mimeiners/hil/files/mom/Meeting_Minutes_06.07.md

# Protokoll vom 06.07.2023

## Abgabe Projekt Gimbal 17.08.2023
### Abgegeben wird:
- Repository vollständig.
- Testkonzepte.
- funktionierender Gimbal
