mimeiners/hil/files/mom/Meeting_Minutes_14_06.md

# Testkonzept stand 14.06

* Sensor-Genauigkeitstest
* Reaktionsgeschwindigkeitstest
* Stabilitätstest
  
## Aufgabe bis zum 15.06
Gedanken für ein Testkonzept machen (Magic System reinschauen) und dann in der Gruppe besprechen
(Nur für Hardware!)

## Aufgabe zum 15.06
 1. Start mit der besprechnung vom Testkonzept.
 2. Zusammenbaum vom Gimbal erster aufbau und ggf. neuen 3D Druck starten
