mimeiners/hil/files/mom/Meeting_Minutes_25_05.md

# Protokoll vom 25.05
Aufgaben bis zum 01.06.
## Team Elektronik

### Aufgaben
**Motoren Ansteuern mit dem ESP und dem Arduino**

---

## Team 3D

### Aufgaben
**Bis nächste Woche soll SE Demonstrator_1.0 auf das nötigste gekürzt werden.**
