mimeiners/hil/files/mom/Meeting_Minutes_11_05.md

# Protokoll vom 11.05

Das Team hat beschlossen, sich in zwei Gruppen aufzuteilen, um mögliche Fernsteuerungen in das Projekt einzubinden. Es werden zwei Microcontroller verwendet: Arduino Nano und ESP.

## Elektronik TEAM ARDUINO
- Xingpeng Chen
- Qian Liu

## Elektronik TEAM ESP
- Xie Yang
- Bola Poules

---

## 3D TEAM ARDUINO
- Atakan Baydogan
- Yolande Maeva Pokam Fotue (50% Beteiligung)

## 3D TEAM ESP
- Yasincan Kahraman
- Yolande Maeva Pokam Fotue (50% Beteiligung)

Kommentar: Bis die Microcontroller programmiert sind, wird das 3D-Druck-Team die Grundidee bzw. die Theorie für "Hardware in the Loop" entwickeln.
