mimeiners/hil/class/01_lec.md

# Einleitung und Übersicht

"Das modellbasierte System-Engineering (MBSE) ist eine formalisierte Methodik, die zur Unterstützung der Anforderungen,
des Entwurfs, der Analyse, der Verifizierung und der Validierung im Zusammenhang mit der Entwicklung komplexer Systeme
eingesetzt wird. Im Gegensatz zum dokumentenzentrierten Engineering stellt MBSE die Modelle in den Mittelpunkt des
Systementwurfs. Die zunehmende Verbreitung digitaler Modellierungsumgebungen in den letzten Jahren hat zu einer
verstärkten Anwendung von MBSE geführt. Im Januar 2020 stellte die NASA diesen Trend fest, indem sie berichtete, dass
MBSE sowohl von der Industrie als auch von der Regierung zunehmend als Mittel zur Beherrschung der Systemkomplexität
angenommen wird. In diesem Blogbeitrag gebe ich eine kurze Einführung in MBSE." [@shevchenko2020]

Übersetzt mit www.DeepL.com/Translator (kostenlose Version)

## Lernziele des Moduls

* Systems Engineering (SE)

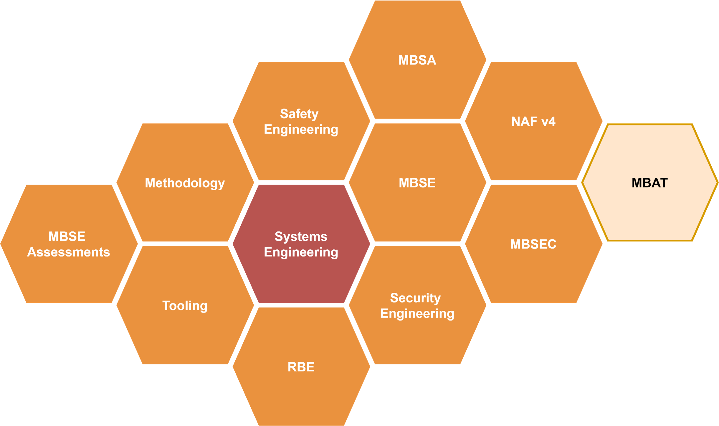
[picture p17: images/Overview_SE.png]
Übersicht Systems Engineering


* Requirements Based Engineering (RE)

	* Grundlegende Prinzipien

	* Stakeholder Requirements

	* System Requirements

	* Requirements Compliance

	* Requirements schreiben

	* Verlinken & attributieren von Requirements

	* Verifikation & Validierung von Requirements

::: {.callout-note}
Verifizierung oder Verifikation (von lateinisch veritas ‚Wahrheit‘ und facere ‚machen‘) ist der Nachweis, dass ein
vermuteter oder behaupteter Sachverhalt wahr ist. [@dewiki:246302640]
:::

::: {.callout-note}
Validierung oder Validation (von lateinisch validus "kräftig, wirksam, fest")[@dewiki:249118232]

* Validierung (Chipentwurf), Vergleich des Chipdesigns mit der vorgegebenen Spezifikation.

* Validierung (Informatik), Nachweisführung, dass ein System die Praxisanforderungen erfüllt.
:::

* Model-Based Systems Engineering (MBSE)

	* SysML als Basis für MBSE

	* Diagramme der SysML

	

	* Alternative MBSE-Sprachen

	* Tooling

* Methodiken und Prozesse

	* MBSE Assessment

	* MBSE Prozess

	* MBSA - Model Based Safety Analysis

	* MBAT - Model Based Analysis and Testing

	* MBSec - Model Based Security

## Wissenschaftliches Rechnen / Modellierung

* [CATIA | No Magic](https://docs.nomagic.com/display/MSI2024xR1/User+Guide)

* [Matlab (Campus Lizenz)](https://de.mathworks.com/academia/tah-portal/hochschule-bremen-31463273.html)

* [Python (Anaconda)](https://www.anaconda.com/download/)

* [Command-line tools](https://jeroenjanssens.com/seven/) 

## Betriebssystemwerkzeuge / OS-Tools

* [Microsoft-Terminal](https://github.com/microsoft/terminal)

* [Microsoft-PowerShell](https://learn.microsoft.com/de-de/powershell/scripting/learn/ps101/01-getting-started?view=powershell-7.4)

* [MacOS-Terminal](https://iterm2.com)

* [Linux/MacOS Shell zsh-tools](https://ohmyz.sh),

* [git (Versionskontrolle)](https://git-scm.com)

## Editoren

* [Visual Studio Code](https://code.visualstudio.com)

* [Spyder IDE](https://www.spyder-ide.org)

* [Emacs](https://www.gnu.org/software/emacs/)

* [Vim](https://www.vim.org)

## Dokumentation / Publish Computational Content

* [Jupyter-Book](https://jupyterbook.org/en/stable/intro.html)

* [quarto](https://quarto.org)

### Schreibst Du noch oder TeXst Du schon?

* [MikTeX (Windows, MacOS, Linux)](https://miktex.org/)

* [MacTeX (MacOS)](https://www.tug.org/mactex/)

* [TeXLive (Linux)](http://tug.org/texlive/)

### LaTeX Editoren

* IDE's
  * [TeXStudio](http://www.texstudio.org)
  * [TeXMaker](http://www.xm1math.net/texmaker/)

* Kollaborative Frameworks
  * [Overleaf, Online LaTeX](https://www.overleaf.com/)
  * [CoCalc - Online LaTeX](https://cocalc.com/doc/latex-editor.html)

### Literaturverwaltung und LaTeX

* [Citavi im Detail > Titel exportieren > Export nach BibTeX](https://www1.citavi.com/sub/manual5/de/exporting_to_bibtex.html)

* [RefWorks - Library Guide Univ. Melbourne](https://unimelb.libguides.com/c.php?g=565734\&p=3912294)

* [Benutzerdefinierte BibTex-Keys mit Zotero | nerdpause](https://nerdpause.de/benutzerdefinierte-bibtex-keys-mit-zotero/)

* [JabRef - Library Guide Univ. Melbourne](https://unimelb.libguides.com/c.php?g=565734\&p=3897117)

* [EndNote - Library Guide Univ. Melbourne](https://unimelb.libguides.com/latexbibtex/endnote)
