mimeiners/hil/class/01_syseng.md

# Systems Engineering

* Validierung oder Validation (von lateinisch validus "kräftig, wirksam, fest")
    * Validierung (Chipentwurf), Vergleich des Chipdesigns mit der vorgegebenen Spezifikation
    * Validierung (Informatik), Nachweisführung, dass ein System die Praxisanforderungen erfüllt

* Verifizierung oder Verifikation (von lateinisch veritas ‚Wahrheit‘ und facere ‚machen‘) 
    ist der Nachweis, dass ein vermuteter oder behaupteter Sachverhalt wahr ist

## Requirements Based Engineering

## Model-Based Systems Engineering

## In-the-Loop Methodik (MBAT)
