mimeiners/hil/images/circuit.png

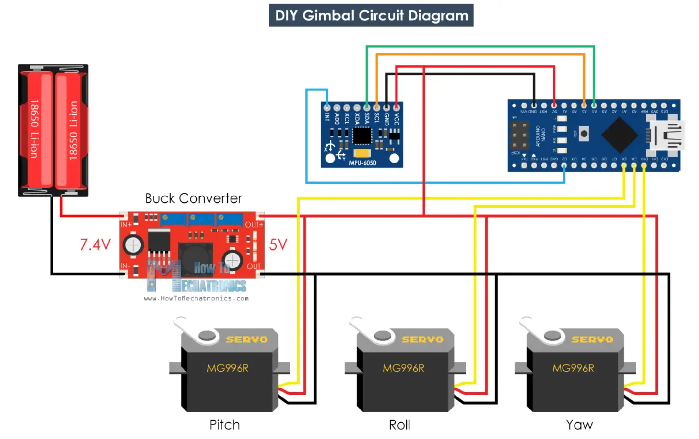
images/circuit.png
