mimeiners/hil/images/Kardanischer-Kompass.jpg

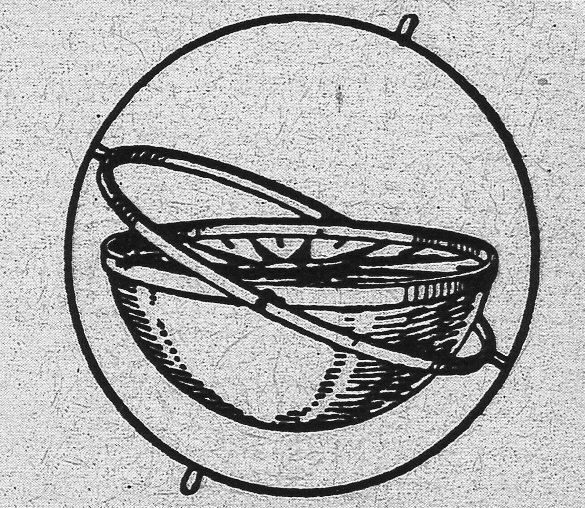
images/Kardanischer-Kompass.jpg
