mimeiners/hil/files/order/MBSE Demonstrator Materialliste.xlsx

Bestellliste MBSE Demonstrator (Arduino Gimbal)
Bezeichnung | Artikelnummer | Bezug | Preis | Anzahl | Gesamtpreis
Beschleunigung & Gyroskop, mit Head MPU-6050 | DEBO SENS 3 AXIS | Reichelt (https://www.reichelt.de/entwicklerboards-beschleunigung-gyroskop-3-achsen-mpu-6050-debo-sens-3axis-p253987.html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) | 2.99 € | 1 | 2.99 €
Beschleunigung & Gyroskop, mit Head MPU-6050 | Packungseinheit 3 Stk. | Amazon (https://www.amazon.de/dp/B07TKLYBD6?linkId=c662abfcd663eb85e01ae5a1577b25be&language=de_DE) | 8.99 € | 1 | 8.99 € | Datasheet (https://invensense.tdk.com/products/motion-tracking/6-axis/mpu-6050/)
 | RBS10997 | Roboter Bausatz (https://www.roboter-bausatz.de/p/mg996r-digital-servo-motor-mit-metall-getriebe?sPartner=8) | 9.95 € | 3 | 29.85 €
MG996R Digital Servo Motor |  | Eckstein GmbH (https://eckstein-shop.de/WaveShare-MG996R-Servo-Metal-Gear-Motor-High-Torque-180Grad) | 6.50 € | 3 | 19.50 €
MG996R Digital Servo Motor | Packungseinheit 3 Stk. | Amazon (https://www.amazon.de/dp/B07H88DB8R?linkId=1f805d2b00fd26176a79f3ea89238fc7&language=de_DE) | 20.99 € | 1 | 20.99 €
Spannugsregler, DC/DC-Wandler | DEBO DCDC DOWN 2 | Reichelt (https://www.reichelt.de/entwicklerboards-spannungsregler-dc-dc-wandler-lm2596-debo-dcdc-down-2-p282579.html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) | 4.15 € | 1 | 4.15 €
Pemenol DC/DC Converter | Packungseinheit 3 Stk. | Amazon (https://www.amazon.de/PEMENOL-Stromversorgung-Spannungsregler-Abwärtswandler-Hocheffizienter/dp/B07FXBXJC5?linkId=cf615256e54154a96298612f239eaaa6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) | 10.85 € | 1 | 10.85 €
Batteriehalter für 2 AA | HALTER 2XUM3-KA | Reichelt (https://www.reichelt.de/batteriehalter-fuer-2-mignonzellen-aa-mit-anschlusskabel-halter-2xum3-ka-p176721.html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) | 0.99 € | 1 | 0.99 €
Lithium Batterie, AA 3.6V | LS14500 | Reichelt (https://www.reichelt.de/lithium-batterie-aa-mignon-2600-mah-1er-pack-ls-14500-p135659.html?PROVID=2788) | 4.90 € | 4 | 19.60 €
Arduino Nano | ARDUINO NANO | Reichelt (https://www.reichelt.de/arduino-nano-v3-atmega-328-mini-usb-arduino-nano-p142943.html?trstct=pos_0&nbc=1) | 20.40 € | 1 | 20.40 €
NodeMCU V3 Base Plate I/O Breakout Sensor | 3771 | MakerShop (https://www.makershop.de/plattformen/nodemcu/nodemcu-base/) | 4.30 € | 1 | 4.30 €
NodeMCU V3.4 ESP8266 ESP-12 E Lua CH340 | 7779 | MakerShop (https://www.makershop.de/plattformen/nodemcu/nodemcu-base/) | 6.30 € | 1 | 6.30 €
