mimeiners/hil/files/3d-druck/DIY_Arduino_Gimbal_STL_Files/Base 03 - Pitch servo.STL

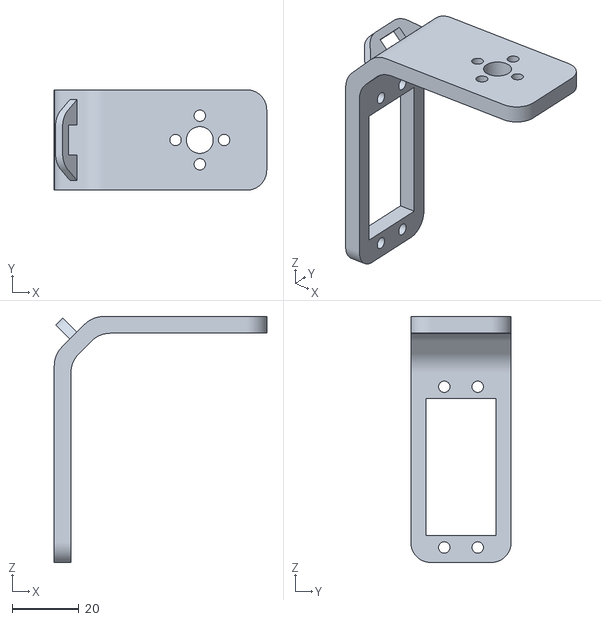
[picture p21: CAD file, 2023-04-27]
files/3d-druck/DIY_Arduino_Gimbal_STL_Files/Base 03 - Pitch servo.STL
63.5 x 30.0 x 73.5
