mimeiners/hil/files/3d-druck/STL_files/Erster_Druck/Top platform.STL

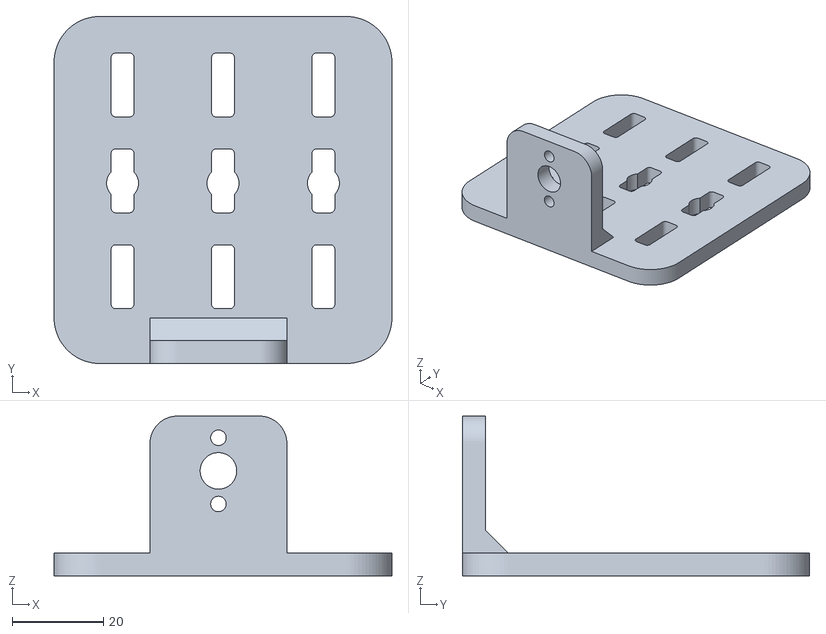
[picture p22: CAD file, 2023-04-27]
files/3d-druck/STL_files/Erster_Druck/Top platform.STL
74.0 x 76.0 x 35.0
