mimeiners/hil/files/3d-druck/STL_files/Erster_Druck/Base 02 - Roll servo.STL

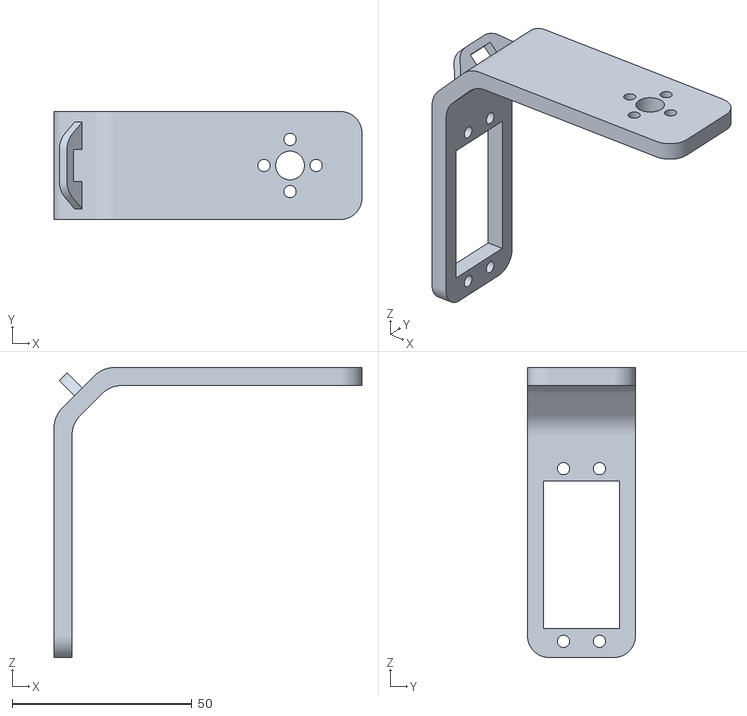
[picture p23: CAD file, 2023-04-27]
files/3d-druck/STL_files/Erster_Druck/Base 02 - Roll servo.STL
85.6 x 30.0 x 80.6
