mimeiners/hil/files/3d-druck/STL_files/Finaler_Druck/Base 01 - Yaw servo - Bananen_Buchsen.stl

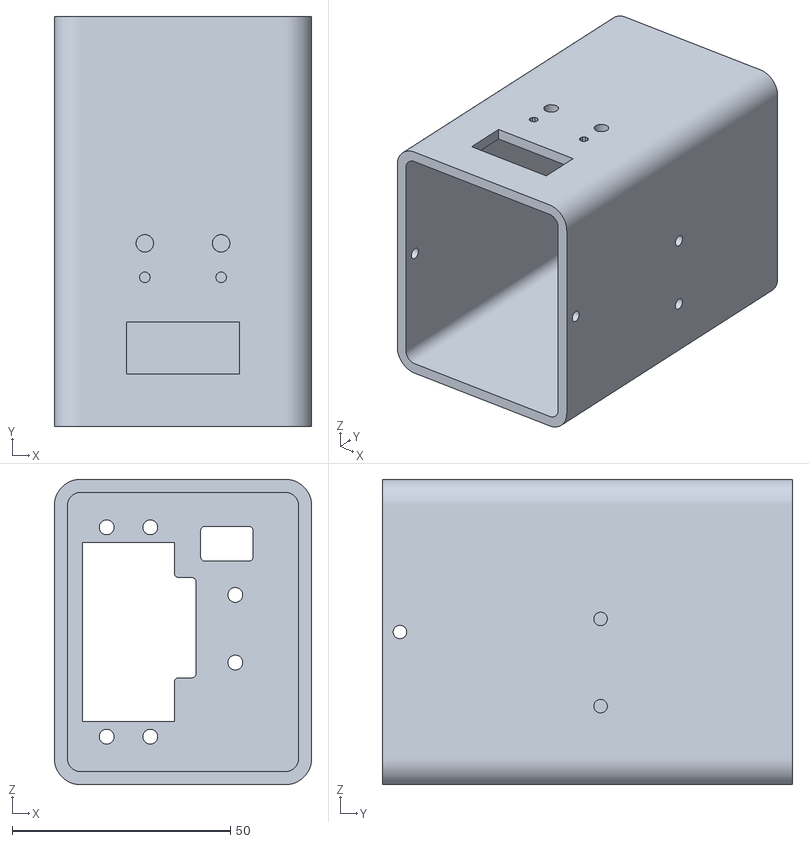
[picture p24: CAD file, 2023-07-28]
files/3d-druck/STL_files/Finaler_Druck/Base 01 - Yaw servo - Bananen_Buchsen.stl
59.0 x 94.0 x 70.0
