mimeiners/hil/files/3d-druck/DIY_Arduino_Gimbal_STL_Files/bottom cover.STL

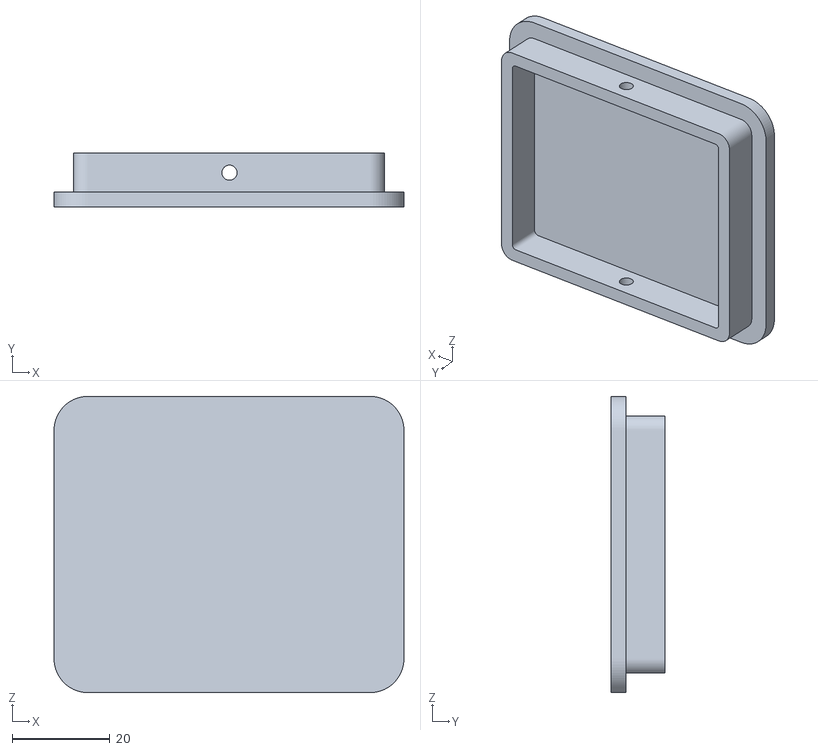
[picture p25: CAD file, 2023-04-27]
files/3d-druck/DIY_Arduino_Gimbal_STL_Files/bottom cover.STL
71.8 x 11.0 x 60.8
