mimeiners/hil/(list of files, cad)

Other CAD files:
files/3d-druck/STL_files/Finaler_Druck/Base 03 - Pitch servo_new.stl
files/3d-druck/STL_files/Finaler_Druck/Base 02 - Roll servo_new.stl
files/3d-druck/STL_files/Erster_Druck/Base 01 - Yaw servo.STL
files/3d-druck/DIY_Arduino_Gimbal_STL_Files/Base 01 - Yaw servo.STL
files/3d-druck/Inventor_files/Erster_Druck/Base 01 - Yaw servo/Base 01 - Yaw servo.ipt
files/3d-druck/Inventor_files/Erster_Druck/Base 02 - Roll servo/Base 02 - Roll servo.ipt
files/3d-druck/Inventor_files/Erster_Druck/Base 03 - Pitch servo/Base 03 - Pitch servo.ipt
files/3d-druck/Inventor_files/Erster_Druck/Top platform/Top platform.ipt
files/3d-druck/Inventor_files/Erster_Druck/bottom cover/bottom cover.ipt
files/3d-druck/Inventor_files/Erster_Druck/bottom cover/bottom cover_with handle.ipt
files/3d-druck/Inventor_files/Finaler_Druck/Base 01 - Yaw servo/Base 01 - Yaw servo.ipt
files/3d-druck/Inventor_files/Finaler_Druck/Base 01 - Yaw servo/OldVersions/Base 01 - Yaw servo.0001.ipt
files/3d-druck/Inventor_files/Finaler_Druck/Base 02 - Roll servo/Base 02 - Roll servo.ipt
files/3d-druck/Inventor_files/Finaler_Druck/Base 02 - Roll servo/OldVersions/Base 02 - Roll servo.0001.ipt
files/3d-druck/Inventor_files/Finaler_Druck/Base 03 - Pitch servo/Base 03 - Pitch servo.ipt
files/3d-druck/Inventor_files/Finaler_Druck/Base 03 - Pitch servo/OldVersions/Base 03 - Pitch servo.0001.ipt
files/3d-druck/Inventor_files/Finaler_Druck/Top platform/Top platform.ipt
files/3d-druck/Inventor_files/Finaler_Druck/bottom cover/bottom cover.ipt
files/3d-druck/Inventor_files/Finaler_Druck/bottom cover/bottom cover_with handle.ipt
