mimeiners/hil/projects/gimbal/00_test_format.md

# Überschrift
Die genaue überschrift vom Testkonzept.

## Cameo Testnummer
Bennenung der zum Testkonzept zugeschriebenen nummer aus den Cameo anforderungen

## Einleitung
Beschreibung des Zwecks und Ziels der Prüfung zur Überprüfung der Leistungsparameter des zu prüfenden Bauteils.

## Testkonzept
Beschreibung des geplanten Vorgehens und der Methodik zur Durchführung des Tests zur Überprüfung der Leistungsparameter.

## Testanforderungen
Auflistung der spezifischen Anforderungen, die das elektronische Gerät erfüllen muss, um als akzeptabel betrachtet zu werden.

## Zustand des Geräts
Beschreibung des aktuellen Zustands des Geräts vor Beginn des Tests.

## Durchführung
Schritt-für-Schritt-Anleitung zur Durchführung des Tests, einschließlich der erforderlichen Verbindungen, Messungen und anderen relevanten Schritten.

## Ergebnisvergleich mit Anforderung
Erläuterung, wie die Ergebnisse des Tests mit den definierten Anforderungen verglichen und bewertet werden sollen, um festzustellen, ob das elektronische Gerät die Leistungsparameter erfüllt.
