mimeiners/hil/projects/gimbal/00_test_ideas.md

# Poetential Testcases

- Maximale Gesschwindigkeit (ab wann ist unser Gimbal Instabil z.B. auf dem Fahrrad)

- Maximale Traglast vom Gimbal

- Maximale Baterielaufzeit
