mimeiners/hil/images/Overview_SysML_FhG.pdf

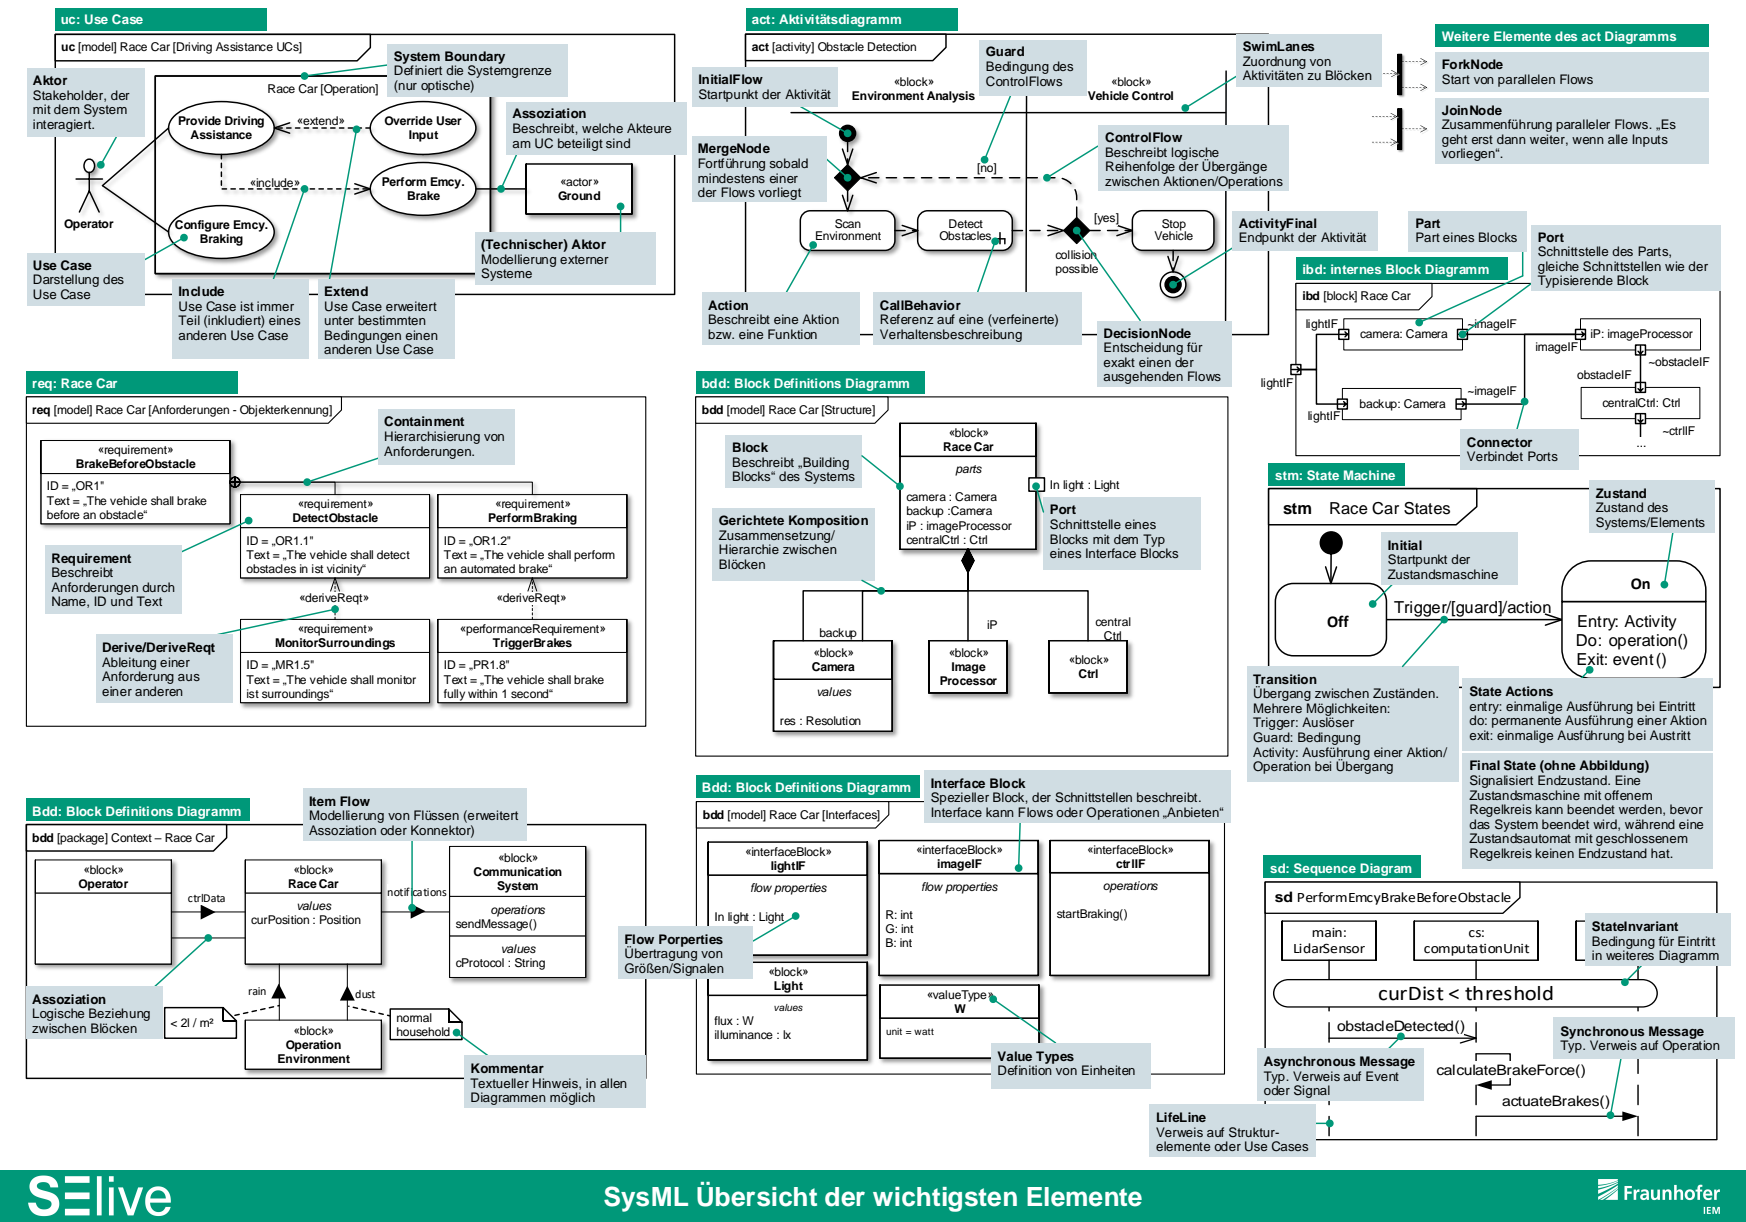
[picture p26: page 1]
Operator; Provide Driving Assistance; Override User Input; Perform Emcy. Brake; Configure Emcy. Braking; «actor» Ground; «extend»; «include»; «requirement» BrakeBeforeObstacle; «requirement» DetectObstacle; «requirement» PerformBraking; «requirement» MonitorSurroundings; «performanceRequirement» TriggerBrakes; «deriveReqt»; «block» Operator; values curPosition : Position; «block» Race Car; values cProtocol : String; operations sendMessage(); «block» Communication; «block» Operation Environment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

Weitere Elemente des act Diagramms

uc [model] Race Car [Driving Assistance UCs]

System Boundary
Definiert die Systemgrenze
(nur optische)

act [activity] Obstacle Detection

ForkNode
Start von parallelen Flows

Aktivitäten zu Blöcken InitialFlow
Startpunkt der Aktivität

Aktor
Stakeholder, der
mit dem System
interagiert.

Race Car [Operation]

Assoziation
Beschreibt, welche Akteure
am UC beteiligt sind

JoinNode
Zusammenführung paralleler Flows. „Es
geht erst dann weiter, wenn alle Inputs
vorliegen“.

ControlFlow
Beschreibt logische
Reihenfolge der Übergänge
zwischen Aktionen/Operations

MergeNode
Fortführung sobald
mindestens einer
der Flows vorliegt

ActivityFinal
Endpunkt der Aktivität

Part
Part eines Blocks

Port
Schnittstelle des Parts,
gleiche Schnittstellen wie der
Typisierende Block

Systeme Use Case
Darstellung des
Use Case

ibd: internes Block Diagramm

Include
Use Case ist immer
Teil (inkludiert) eines
anderen Use Case

Extend
Use Case erweitert
unter bestimmten
Bedingungen einen

ibd [block] Race Car

Action
Beschreibt eine Aktion
bzw. eine Funktion

CallBehavior
Referenz auf eine (verfeinerte)
Verhaltensbeschreibung

DecisionNode
Entscheidung für
exakt einen der
ausgehenden Flows

req [model] Race Car [Anforderungen - Objekterkennung]

bdd [model] Race Car [Structure]

Block
Beschreibt „Building
Blocks“ des Systems

stm: State Machine

Text = „The vehicle shall brake
before an obstacle“

In light : Light

Schnittstelle eines
Blocks mit dem Typ
eines Interface Blocks

stm Race Car States

Text = „The vehicle shall detect
obstacles in ist vicinity“

Text = „The vehicle shall perform
an automated brake“

Requirement
Beschreibt
Anforderungen durch
Name, ID und Text

Trigger/[guard]/action

Text = „The vehicle shall monitor
ist surroundings“

fully within 1 second“

Transition
Übergang zwischen Zuständen.
Mehrere Möglichkeiten:
Trigger: Auslöser
Guard: Bedingung
Activity: Ausführung einer Aktion/
Operation bei Übergang

State Actions
entry: einmalige Ausführung bei Eintritt
do: permanente Ausführung einer Aktion
exit: einmalige Ausführung bei Austritt

Final State (ohne Abbildung)
Signalisiert Endzustand. Eine
Zustandsmaschine mit offenem
Regelkreis kann beendet werden, bevor
das System beendet wird, während eine
Zustandsautomat mit geschlossenem
Regelkreis keinen Endzustand hat.

Interface Block
Spezieller Block, der Schnittstellen beschreibt.
Interface kann Flows oder Operationen „Anbieten“

Bdd: Block Definitions Diagramm

Item Flow
Modellierung von Flüssen (erweitert
Assoziation oder Konnektor)

bdd [model] Race Car [Interfaces]

bdd [package] Context – Race Car

sd: Sequence Diagram

System notifications ctrlData

StateInvariant
Bedingung für Eintritt
in weiteres Diagramm

Synchronous Message
Typ. Verweis auf Operation

Value Types
Definition von Einheiten

Asynchronous Message
Typ. Verweis auf Event
oder Signal

Kommentar
Textueller Hinweis, in allen
Diagrammen möglich

LifeLine
Verweis auf Struktur-
elemente oder Use Cases

SysML Übersicht der wichtigsten Elemente
