mimeiners/hil/(commit log)

2023-04-27 Added projec files 3d print and arduino code.
    [Base 01 - Yaw servo.STL, Base 02 - Roll servo.STL, Base 03 - Pitch servo.STL, MBSE Demonstrator Materialliste.xlsx, Top platform.STL, bottom cover.STL]
2023-05-04 Beispiele, Modell und Code im docs Ordner
    [Base 01 - Yaw servo.STL, Base 02 - Roll servo.STL, Base 03 - Pitch servo.STL, MBSE Demonstrator Materialliste.xlsx, Top platform.STL, bottom cover.STL]
2023-05-06 Veränderungen an der Readme Datei getätigt
2023-05-10 Inventor_Datein hinzugefügt
    [Base 01 - Yaw servo.STL, Base 01 - Yaw servo.ipt, Base 02 - Roll servo.STL, Base 02 - Roll servo.ipt, Base 03 - Pitch servo.STL, Base 03 - Pitch servo.ipt, Top platform.STL, Top platform.ipt]
2023-05-19 Einkaufsliste überarbeitet
    [MBSE Demonstrator Materialliste.xlsx]
2023-05-25 MPU 6050 Tutorial und Micropython
2023-06-01 Display MPU-6050 Sensor Readings on OLED Display
2023-06-15 Order bearbeitet
    [MBSE Demonstrator Materialliste.xlsx]
2023-07-06 Servo Steuerung
2023-10-19 Repo für HILV vorbereitet
    [Base 01 - Yaw servo.STL, Base 02 - Roll servo.STL, Base 03 - Pitch servo.STL, Top platform.STL, bottom cover.STL]
2023-10-19 Reorder 1st step
    [MBSE Demonstrator Materialliste.xlsx]
2023-10-19 Full reorder for github pages
    [Base 01 - Yaw servo - Bananen_Buchsen.stl, Base 01 - Yaw servo.0001.ipt, Base 01 - Yaw servo.STL, Base 01 - Yaw servo.ipt, Base 02 - Roll servo.0001.ipt, Base 02 - Roll servo.STL, Base 02 - Roll servo.ipt, Base 02 - Roll servo_new.stl]
